enthali/3dmodels/modelle/baron/preview.png

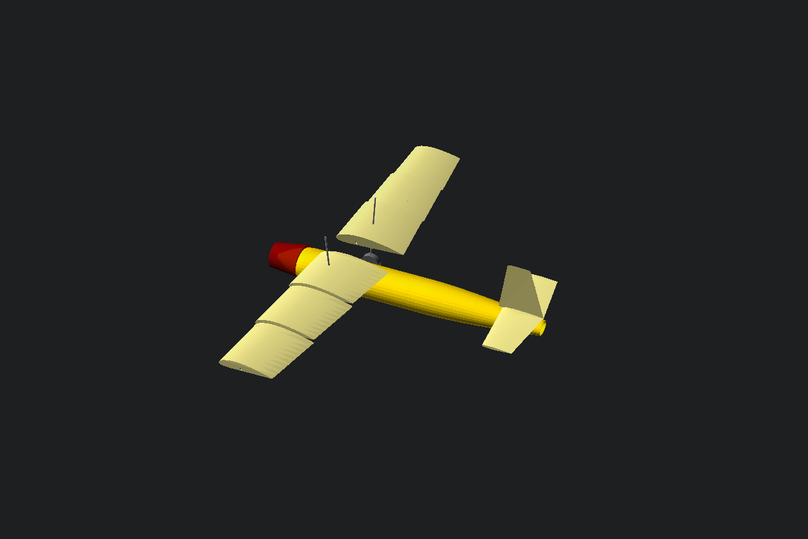
modelle/baron/preview.png
