enthali/3dmodels/modelle/baron/tailplane_preview.png

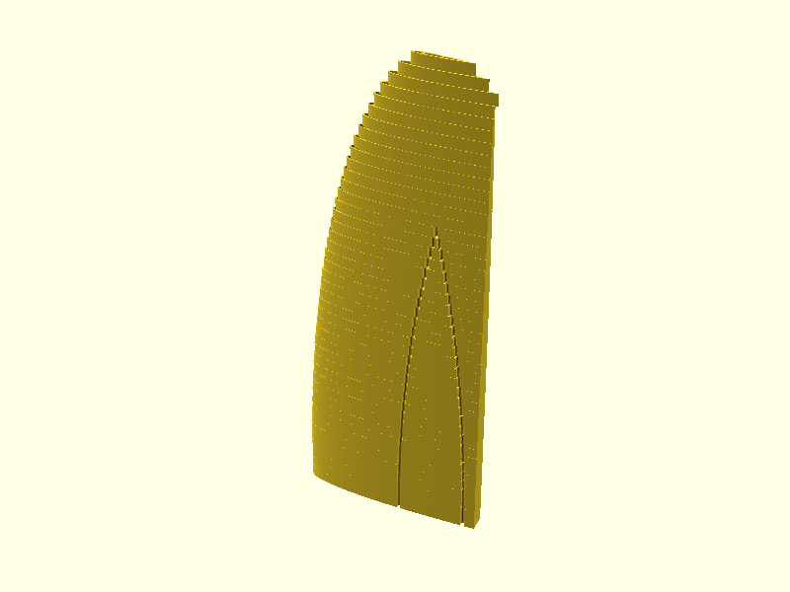
modelle/baron/tailplane_preview.png
