enthali/3dmodels/modelle/baron/seg1_left.scad

// seg1_left.scad – Inneres Segment, linker Halbflügel
// Spannweite 0–200mm (Wurzel), mit Holm-Kanal

use <elliptic_wing.scad>

half_wing_segment(0, 200);
