enthali/3dmodels/modelle/baron/seg1_right.scad

// seg1_right.scad – Inneres Segment, rechter Halbflügel (gespiegelt)
// Spannweite 0–200mm (Wurzel), mit Holm-Kanal

use <elliptic_wing.scad>

rotate([180,0,0])
    mirror([0, 0, 1])
        half_wing_segment(0, 200);
        //elliptic_hollow();
