enthali/3dmodels/modelle/baron/seg2_left.scad

// seg2_left.scad – Mittleres Segment, linker Halbflügel
// Spannweite 200–400mm, mit Holm-Kanal

use <elliptic_wing.scad>

half_wing_segment(200, 400);
