enthali/3dmodels/modelle/baron/seg3_left.scad

// seg3_left.scad – Äußeres Segment (Tip), linker Halbflügel
// Spannweite 400–600mm, ohne Holm (CF-Rohr endet bei 310mm)

use <elliptic_wing.scad>

half_wing_segment(400, 600);
