enthali/3dmodels/modelle/baron/print_segments/aileron_left_seg1.scad

// aileron_left_seg1.scad – Querruder Segment 1 (innen), linker Halbflügel

use <../wing.scad>

aileron_part(seg_boundary(2), seg_boundary(3));
