enthali/3dmodels/modelle/baron/print_segments/aileron_left_seg2.scad

// aileron_left_seg2.scad – Querruder Segment 2 (außen), linker Halbflügel

use <../wing.scad>

aileron_part(seg_boundary(3), seg_boundary(4));
