enthali/3dmodels/modelle/baron/print_segments/wing_seg1_left.scad

// wing_seg1_left.scad – Wurzelsegment, linker Halbflügel
// Spannweite 0–180 mm

use <../wing.scad>

wing_segment(seg_boundary(0), seg_boundary(1));
