enthali/3dmodels/modelle/baron/print_segments/wing_seg2_left.scad

// wing_seg2_left.scad – Inneres Segment, linker Halbflügel
// Spannweite 180 mm bis Querruder-Beginn

use <../wing.scad>

wing_segment(seg_boundary(1), seg_boundary(2));
