enthali/3dmodels/modelle/baron/print_segments/wing_seg3_left.scad

// wing_seg3_left.scad – Querruder-Zone, linker Halbflügel (Flügel ohne Ruder)
// Spannweite Querruder-Beginn bis Querruder-Ende

use <../wing.scad>

wing_segment(seg_boundary(2), seg_boundary(3));
