enthali/3dmodels/modelle/baron/print_segments/wing_seg4_left.scad

// wing_seg4_left.scad – Querruder-Ende bis Randbogen, linker Halbflügel

use <../wing.scad>

wing_segment(seg_boundary(3), seg_boundary(4));
