enthali/3dmodels/modelle/baron/print_segments/wing_seg5_left.scad

// wing_seg5_left.scad – Randbogen, linker Halbflügel
// Äußerstes Segment (halbe Länge)

use <../wing.scad>

wing_segment(seg_boundary(4), seg_boundary(5));
