enthali/3dmodels/(commit log)

2026-02-07 Add Baron project: 1920s RC high-wing monoplane - Parametric OpenSCAD model with NACA 4415 wing profile - Auto-segmentation for FlashForge Adventurer 5M print bed - Shared libraries: airfoil.scad, co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
    [baron.scad]
2026-02-07 Wing: NACA 4415 half-wing with shear V-form and spar channel - Single half_wing() module, mirrored in assembly - 250mm root / 200mm tip chord, 500mm half-span - 3° V-form via multmatrix shear (flat b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
    [assembly.scad, wing.scad]
2026-02-07 wing_segment: Nasenleiste + Endleiste (massiv, abgerundet)
    [wing_segment.scad]
2026-02-08 wing_segment: gelochte Rippen, Holmbohrung, Hülle - bereit für Testdruck
    [wing_segment.scad]
2026-02-08 wing_segment: PLA-Variante - wall=0.4, rib_wall=0.8, gelochte Rippen, ohne Nase/Endleiste, Parameter aufgeräumt
    [wing_segment.scad]
2026-02-08 wing_segment: Rippen versetzt (halber Abstand), rib_spacing=40mm, weniger Gewicht
    [wing_segment.scad]
2026-02-08 elliptic_wing: Modul half_wing_segment(z_start, z_end) + 6 Segment-Dateien (3 pro Seite)
    [elliptic_wing.scad, seg1_left.scad, seg1_right.scad, seg2_left.scad, seg2_right.scad, seg3_left.scad, seg3_right.scad]
2026-02-08 Remove obsolete JSON configuration files and update assembly script for improved wing assembly structure
    [assembly.scad, wing.scad]
2026-02-08 Elliptischer Flügel: Filament-Grooves, hohle Kreuzrippen, Layer-Slicing - elliptic_wing.scad: linear_extrude pro Layer statt hull() → Grooves bleiben erhalten, step=0.2mm beim Export - lib/grooves.sc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
    [elliptic_wing.scad]
2026-02-08 Washout 3° ab 200mm, Wurzelrippe entfernt (Brim), Cleanup
    [elliptic_wing.scad, seg1_right.scad, seg3_right.scad]
2026-02-10 Update groove parameters for improved filament fit and depth
2026-02-10 Add aileron parameters and hinge calculations for improved control surface definition
    [elliptic_wing.scad]
2026-02-14 Aileron: Zone-Schnitt, Closure-Ribs, 4-Segment-Layout, Print-Dateien
    [aileron_left.scad, baron.scad, wing_seg1_left.scad, wing_seg1_right.scad, wing_seg2_left.scad, wing_seg2_right.scad, wing_seg3_left.scad, wing_seg3_right.scad]
2026-02-14 Entferne verwaiste wing_seg3_right.scad
    [assembly.scad, elliptic_wing.scad, wing_seg1_left.scad, wing_seg1_right.scad, wing_seg2_left.scad, wing_seg2_right.scad, wing_seg3_left.scad, wing_seg3_right.scad]
2026-02-14 Remove elliptic_wing.scad and create a backup as elliptic_wing_old.scad
    [elliptic_wing_old.scad]
2026-02-15 Per-Slice Architektur: Aileron mit Bevel, Hinge-Walls, gerader Scharnierlinie - Kompletter Refactor: Per-Slice 2D statt 3D-Booleans - Aileron-Zonen: closure_wing, gap, closure_aileron, aileron - Flüg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
    [elliptic_wing.scad]
2026-02-15 Update rib_apparent_w calculation to reflect desired width in slice
    [elliptic_wing.scad]
2026-02-15 Segmente + Assembly: half_wing_segment → wing_segment, Kommentare aktualisiert
    [assembly.scad, wing_seg1_left.scad, wing_seg2_left.scad, wing_seg3_left.scad, wing_seg4_left.scad]
2026-02-15 Remove deprecated elliptic_wing_old.scad file
    [elliptic_wing_old.scad]
2026-02-15 5-Segment-Layout mit gesplittetem Querruder
    [aileron_left.scad, aileron_left_seg1.scad, aileron_left_seg2.scad, assembly.scad, elliptic_wing.scad, wing_seg4_left.scad, wing_seg5_left.scad]
2026-02-15 Adjust fuselage placeholder dimensions and refine segment boundary calculation for aileron gap
    [assembly.scad, elliptic_wing.scad]
2026-02-15 Adjust wing incidence and modify aileron segment positioning for improved aerodynamics
    [assembly.scad, elliptic_wing.scad]
2026-02-15 Refactor Baron RC aircraft model for improved structure and design
    - Updated README.md with detailed design philosophy, technical specifications, and segmentation information.
    - Refactored assembly.scad to integrate new fuselage and tailplane modules.
    - Created fuselage.scad for parametric fuselage design with internal reinforcement options.
    - Introduced tailplane.scad for elliptical tailplane geometry, including elevator segments.
    - Updated wing.scad to serve as the main configuration for wing segments and ailerons.
    - Adjusted segment files for ailerons and wing segments to utilize the new wing module.
    - Enhanced parameter handling in elliptic_wing.scad for better configurability.
    - Added n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
    [aileron_left_seg1.scad, aileron_left_seg2.scad, assembly.scad, elevator_left_seg1.scad, elliptic_wing.scad, fuselage.scad, htail_seg1_left.scad, htail_seg2_left.scad]
2026-02-20 Refactor wing/tailplane parameter flow and hinge geometry
    [assembly.scad, elliptic_wing.scad, tailplane.scad, wing.scad]
2026-02-28 feat: rib-shell gap (0.01mm) fuer durchgehende Slicer-Perimeter - rib_shell_gap Parameter in elliptic_wing.scad: Rippen/Stege enden 0.01mm vor der Huellen-Innenkante -> Slicer druckt Aussenhuelle als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
    [c-hinge.scad, elevator_left_seg1.scad, elliptic_wing.scad, htail_seg1_left.scad, htail_seg2_left.scad, tailplane.scad]
